mad3001/Multiply/PCB/Multiply_Schematic.png

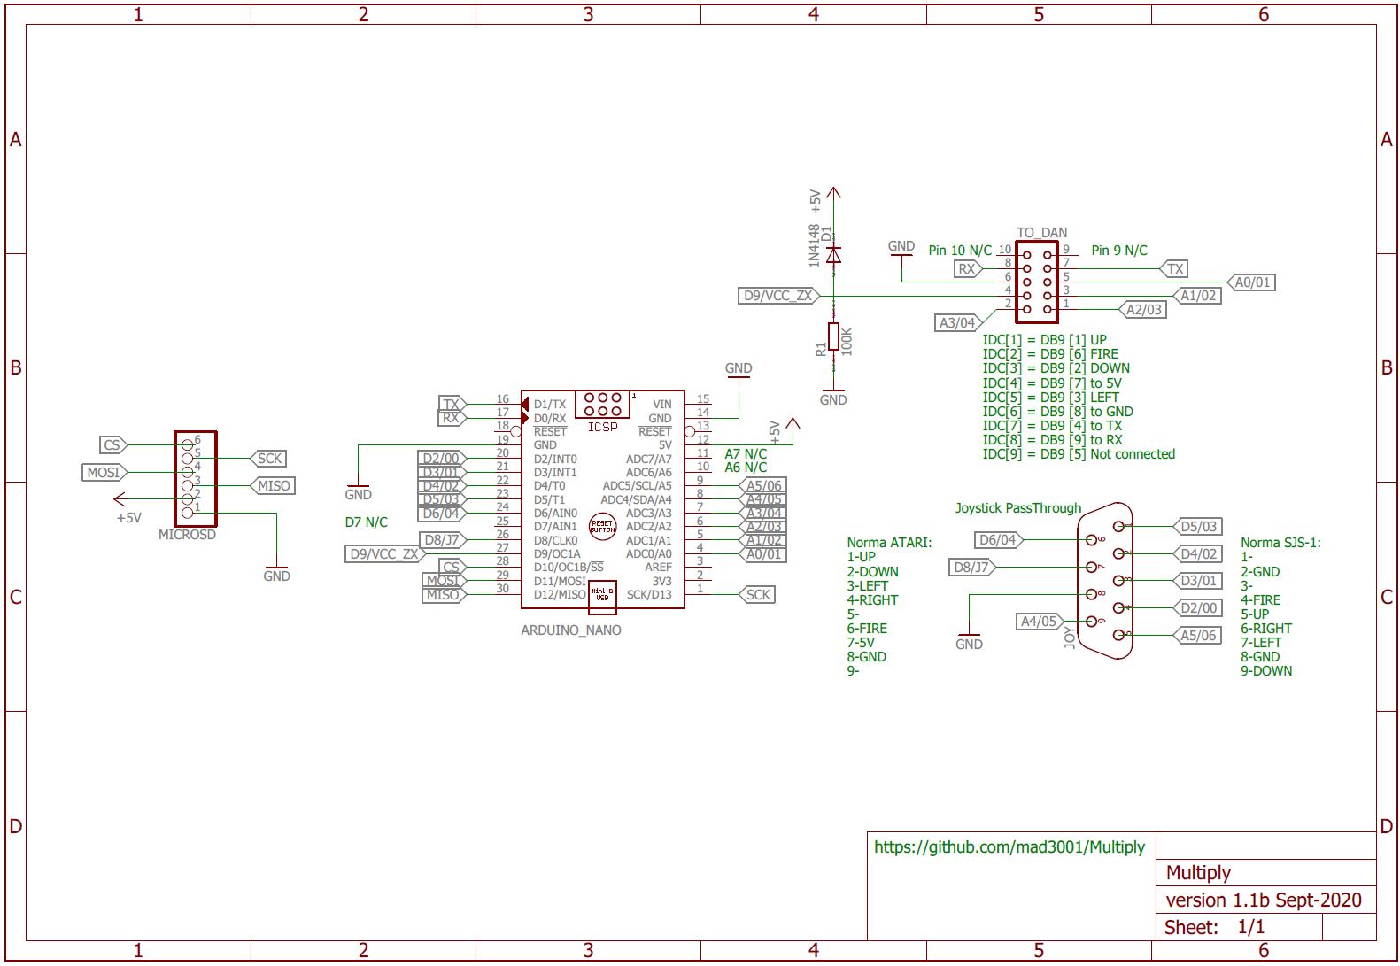
PCB/Multiply_Schematic.png
