mad3001/Multiply/(commit log)

2020-12-26 NO SD empty dir
    Fix for No SD in Multiply so empty Dir remain (before it hanged with "Retrieving Files" text in screen
    [Multiply_Arduino.ino, libFileList.ino]
2021-05-07 Fixed cmdBufSize 16
    Fixed cmdBufSize 16 to avoid problems with libTAP
    [Multiply_Arduino.ino]
2023-01-18 Update readme.md
    Updated warning about scammers in pcbway
2023-05-02 Update libFileList.ino
    Fixed bad performance message appears although all files were correctly sorted in SD card. Thanks to berarma
    [libFileList.ino]
2023-05-02 Updated multiply code for arduino nano
